gbrnt/ploopy-nano/hardware/mechanicals-btu-mod/STEPs/Ploopy-Nano-Top-BTU-v1.stp

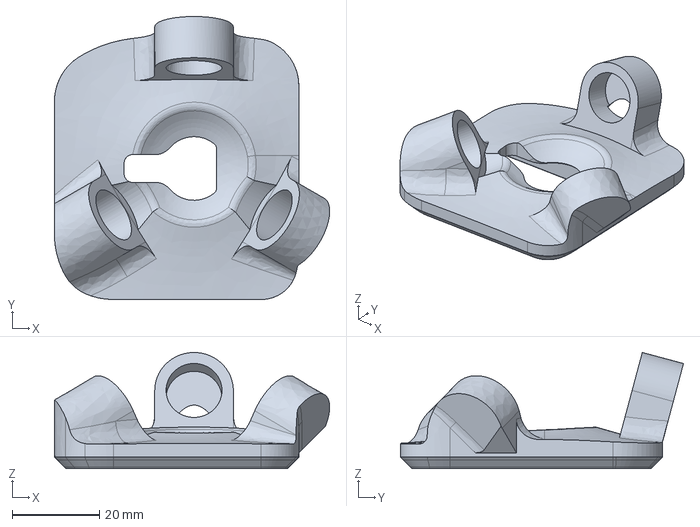
[picture p3: CAD file, 2021-08-19]
hardware/mechanicals-btu-mod/STEPs/Ploopy-Nano-Top-BTU-v1.stp
63.1 x 64.8 x 26.6 mm
