gbrnt/ploopy-nano/hardware/mechanicals-btu-mod/STEPs/Ploopy-Nano-Base-BTU-v1.stp

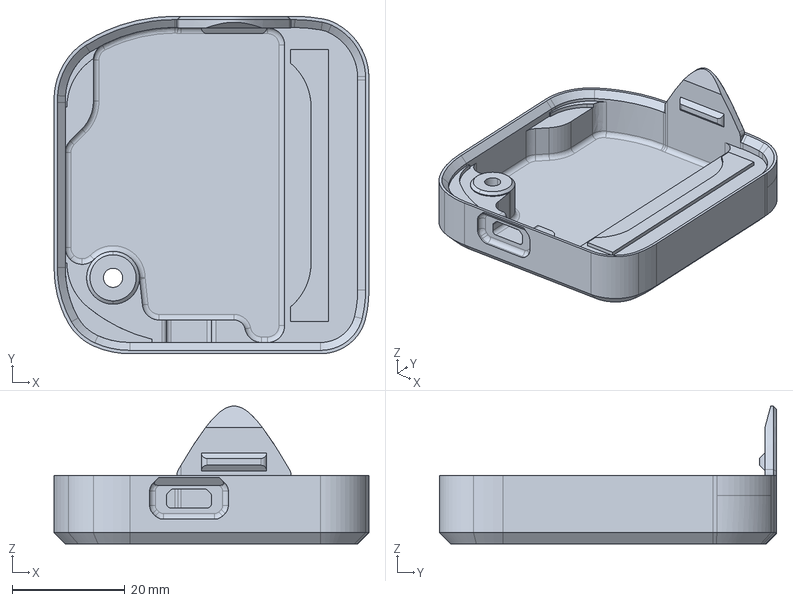
[picture p4: CAD file, 2021-08-19]
hardware/mechanicals-btu-mod/STEPs/Ploopy-Nano-Base-BTU-v1.stp
56.0 x 60.0 x 24.5 mm
