gbrnt/ploopy-nano/(list of files, cad)

Other CAD files:
hardware/mechanicals-btu-mod/STLs/Ploopy-Nano-Base-BTU-v1.stl
hardware/mechanicals-btu-mod/STLs/Ploopy-Nano-Top-BTU-v1.stl
